smily77/Crawler/crawler/Camera.ino

#ifdef FPV
#include "index_html.h"

static esp_err_t index_handler(httpd_req_t *req){
  httpd_resp_set_type(req, "text/html");
  return httpd_resp_send(req, (const char *)INDEX_HTML, strlen(INDEX_HTML));
}

static esp_err_t stream_handler(httpd_req_t *req){
  camera_fb_t * fb = NULL;
  esp_err_t res = ESP_OK;
  size_t _jpg_buf_len = 0;
  uint8_t * _jpg_buf = NULL;
  char * part_buf[64];

  res = httpd_resp_set_type(req, _STREAM_CONTENT_TYPE);
  if(res != ESP_OK){
    return res;
  }
  streamActive = true;   // pause OTA while streaming

  while(true){
    fb = esp_camera_fb_get();
    if (!fb) {
      Serial.println("Camera capture failed");
      res = ESP_FAIL;
    } else {
      if(fb->width > 400){
        if(fb->format != PIXFORMAT_JPEG){
          bool jpeg_converted = frame2jpg(fb, 80, &_jpg_buf, &_jpg_buf_len);
          esp_camera_fb_return(fb);
          fb = NULL;
          if(!jpeg_converted){
            Serial.println("JPEG compression failed");
            res = ESP_FAIL;
          }
        } else {
          _jpg_buf_len = fb->len;
          _jpg_buf = fb->buf;
        }
      }
    }
    if(res == ESP_OK){
      size_t hlen = snprintf((char *)part_buf, 64, _STREAM_PART, _jpg_buf_len);
      res = httpd_resp_send_chunk(req, (const char *)part_buf, hlen);
    }
    if(res == ESP_OK){
      res = httpd_resp_send_chunk(req, (const char *)_jpg_buf, _jpg_buf_len);
    }
    if(res == ESP_OK){
      res = httpd_resp_send_chunk(req, _STREAM_BOUNDARY, strlen(_STREAM_BOUNDARY));
    }
    if(fb){
      esp_camera_fb_return(fb);
      fb = NULL;
      _jpg_buf = NULL;
    } else if(_jpg_buf){
      free(_jpg_buf);
      _jpg_buf = NULL;
    }
    if(res != ESP_OK){
      break;
    }
    //Serial.printf("MJPG: %uB\n",(uint32_t)(_jpg_buf_len));
  }
  streamActive = false;  // client gone, OTA available again
  return res;
}

static esp_err_t cmd_handler(httpd_req_t *req){
  char*  buf;
  size_t buf_len;
  char variable[32] = {0,};
  char xs[8] = {0,}, ys[8] = {0,}, fs[4] = {0,}, vs[4] = {0,};
  
  buf_len = httpd_req_get_url_query_len(req) + 1;
  if (buf_len > 1) {
    buf = (char*)malloc(buf_len);
    if(!buf){
      httpd_resp_send_500(req);
      return ESP_FAIL;
    }
    if (httpd_req_get_url_query_str(req, buf, buf_len) == ESP_OK) {
      if (httpd_query_key_value(buf, "go", variable, sizeof(variable)) == ESP_OK) {
        // optional parameters for web control: x, y (-512..512), f (fire 0/1), v (light 0/1)
        httpd_query_key_value(buf, "x", xs, sizeof(xs));
        httpd_query_key_value(buf, "y", ys, sizeof(ys));
        httpd_query_key_value(buf, "f", fs, sizeof(fs));
        httpd_query_key_value(buf, "v", vs, sizeof(vs));
      } else {
        free(buf);
        httpd_resp_send_404(req);
        return ESP_FAIL;
      }
    } else {
      free(buf);
      httpd_resp_send_404(req);
      return ESP_FAIL;
    }
    free(buf);
  } else {
    httpd_resp_send_404(req);
    return ESP_FAIL;
  }

  sensor_t * s = esp_camera_sensor_get();
  int res = 0;
  
  if(!strcmp(variable, "forward")) {
    Serial.println("Forward");
    processJoystickInput(0, -webSpeed);
  }
  else if(!strcmp(variable, "left")) {
    Serial.println("Left");
    processJoystickInput(-webSpeed/2,0);
  }
  else if(!strcmp(variable, "right")) {
    Serial.println("Right");
    processJoystickInput(webSpeed
    /2,0);
  }
  else if(!strcmp(variable, "backward")) {
    Serial.println("Backward");
    processJoystickInput(0, webSpeed);
  }
  else if(!strcmp(variable, "xy")) {      // XY pad + fire, sent repeatedly while touched
    webX = constrain(atoi(xs), -512, 512);
    webY = constrain(atoi(ys), -512, 512);
    webFire = (atoi(fs) != 0);
    lastWebCmd = millis();
    webActive = true;
    webNew = true;
  }
  else if(!strcmp(variable, "light")) {   // full front light on/off
    webLightReq = (atoi(vs) != 0) ? 1 : 0;
  }
  else if(!strcmp(variable, "camled")) {  // flash LED on the ESP32-CAM board on/off
    webCamLedReq = (atoi(vs) != 0) ? 1 : 0;
  }
  else if(!strcmp(variable, "stop")) {
    Serial.println("Stop");
    stopMotors();
  }
  else {
    res = -1;
  }

  if(res){
    return httpd_resp_send_500(req);
  }

  httpd_resp_set_hdr(req, "Access-Control-Allow-Origin", "*");
  return httpd_resp_send(req, NULL, 0);
}
#endif
#ifdef FPV
// Apply web commands in loop() context; stop if the page stops sending
void handleWebControl() {
  static bool fireOn = false;
  if (webLightReq >= 0) {
    if (crawlerType == CRAWLER_PCA) setFrontLight(webLightReq ? 65 : 0);
    webLightReq = -1;
  }
  if (webCamLedReq >= 0) {
    digitalWrite(CAM_LED_PIN, webCamLedReq ? HIGH : LOW);
    webCamLedReq = -1;
  }
  if (!webActive) return;
  bool fireWanted = webFire;
  if (millis() - lastWebCmd > WEB_TIMEOUT) {   // page released or connection lost
    webActive = false;
    fireWanted = false;
    stopMotors();
  } else if (webNew) {
    webNew = false;
    processJoystickInput(webX, webY);
  }
  if (fireWanted != fireOn) {
    fireOn = fireWanted;
    if (crawlerType == CRAWLER_PCA) setLed(fireOut, fireOn ? 4095 : 0);
  }
}

void startCameraServer(){
  httpd_config_t config = HTTPD_DEFAULT_CONFIG();
  config.server_port = 80;
  httpd_uri_t index_uri = {
    .uri       = "/",
    .method    = HTTP_GET,
    .handler   = index_handler,
    .user_ctx  = NULL
  };

  httpd_uri_t cmd_uri = {
    .uri       = "/action",
    .method    = HTTP_GET,
    .handler   = cmd_handler,
    .user_ctx  = NULL
  };
  httpd_uri_t stream_uri = {
    .uri       = "/stream",
    .method    = HTTP_GET,
    .handler   = stream_handler,
    .user_ctx  = NULL
  };
  if (httpd_start(&camera_httpd, &config) == ESP_OK) {
    httpd_register_uri_handler(camera_httpd, &index_uri);
    httpd_register_uri_handler(camera_httpd, &cmd_uri);
  }
  config.server_port += 1;
  config.ctrl_port += 1;
  if (httpd_start(&stream_httpd, &config) == ESP_OK) {
    httpd_register_uri_handler(stream_httpd, &stream_uri);
  }
}
#endif
void camSetup() {
#ifdef FPV
  camera_config_t config;
  config.ledc_channel = LEDC_CHANNEL_0;
  config.ledc_timer = LEDC_TIMER_0;
  config.pin_d0 = Y2_GPIO_NUM;
  config.pin_d1 = Y3_GPIO_NUM;
  config.pin_d2 = Y4_GPIO_NUM;
  config.pin_d3 = Y5_GPIO_NUM;
  config.pin_d4 = Y6_GPIO_NUM;
  config.pin_d5 = Y7_GPIO_NUM;
  config.pin_d6 = Y8_GPIO_NUM;
  config.pin_d7 = Y9_GPIO_NUM;
  config.pin_xclk = XCLK_GPIO_NUM;
  config.pin_pclk = PCLK_GPIO_NUM;
  config.pin_vsync = VSYNC_GPIO_NUM;
  config.pin_href = HREF_GPIO_NUM;
  config.pin_sccb_sda = SIOD_GPIO_NUM;
  config.pin_sccb_scl = SIOC_GPIO_NUM;
  config.pin_pwdn = PWDN_GPIO_NUM;
  config.pin_reset = RESET_GPIO_NUM;
  config.xclk_freq_hz = 20000000;
  config.pixel_format = PIXFORMAT_JPEG; 
  
  if(psramFound()){
    Serial << "PSRAM" << endl;
    config.frame_size = FRAMESIZE_VGA;
    config.jpeg_quality = 10;
    config.fb_count = 2;
  } else {
    Serial << "No PSRAM" << endl;
    config.frame_size = FRAMESIZE_SVGA;
    config.jpeg_quality = 12;
    config.fb_count = 1;
  }
  // Camera init
  esp_err_t err = esp_camera_init(&config);
  if (err != ESP_OK) {
    Serial.printf("Camera init failed with error 0x%x", err);
    return;
  }
  sensor_t * s = esp_camera_sensor_get();
  s->set_hmirror(s, 1);        // 0 = disable , 1 = enable
  s->set_vflip(s, 1);          // 0 = disable , 1 = enable
#endif
}
