smily77/Crawler/(commit log)

2026-10-15 Initialer Stand: crawler (aus combi10) und OSC_Joystick (aus OSC_Joystick10)
2026-10-15 Dokumentation: README mit Systembeschreibung, Foto und Schemas
    - README beschreibt beide Crawler (ESP32-CAM, Wemos D1 mini), TouchOSC-
    und Joystick-Steuerung, Protokolle, Fahr-/Lichtlogik, Pinbelegung,
    Kompilieren und bekannte offene Punkte
    - docs/: Foto der Crawler und SVG-Schemas für beide Crawler und den Joystick
2026-10-15 Translate documentation and code comments to English
    - README and schematics rewritten in English
    - Code comments and serial messages translated
    - German identifiers renamed: taster -> enableBtnPin, tasterLed -> enableLedPin,
    isHandy -> isPhone, setLed(kanal, helligkeit) -> setLed(channel, brightness)
    - crawler/Kamera.ino renamed to crawler/Camera.ino
    - No functional changes
2026-10-15 Pause OTA while FPV stream is active; port crawler to ESP32 core 3.x
    - OTA: stream_handler sets streamActive while a client watches the
    stream; loop() only calls ArduinoOTA.handle() when no stream is
    active, so OTA no longer causes stutter and is available otherwise.
    - Core 3.x: new ESP-NOW recv/send callback signatures and
    ledcAttachChannel/ledcWriteChannel (same channels 0-3 as before),
    guarded by version checks so core 2.x still compiles.
    Build: esp32:esp32:esp32cam with PartitionScheme=min_spiffs (OTA).
    [Camera.ino, Init.ino, Motors.ino, autoPairEspNow.ino, crawler.ino]
2026-10-15 Add web controls: XY pad, full light and fire buttons
    - New mobile web page (index_html.h) with FPV stream, XY pad for tank
    steering (like the TouchOSC pad, steering limited to 1/3 like the
    hardware joystick), toggle for full front light and hold-to-fire.
    - /action?go=xy&x=&y=&f= and /action?go=light&v= endpoints; the HTTP
    handler only stores values, loop() applies them so PCA9685 access
    stays in one task.
    - Safety: motors stop and fire turns off if no web command arrives
    for 500 ms (pad released, tab hidden or connection lost).
    - HTML moved to a .h file so the Arduino preprocessor does not parse
    the JavaScript.
2026-10-15 Joystick WiFi/ESP-NOW switch, ESP-NOW buttons, ESP8266 crawler support
    Joystick:
    - WiFi (OSC) if it can connect, otherwise ESP-NOW; touch L+R held for
    ~1 s toggles the mode manually. Optional AUTO_MODE_SWITCH (off by
    default) asks the crawler for its WiFi state and falls back on loss.
    - Non-blocking channel scan in ESP-NOW mode, re-pairing after failed
    sends, neutral OSC packet before leaving WiFi mode.
    - Fire (button1) and full light (button2) sent via ESP-NOW, steering
    limited to 1/3 like OSC, sends to the paired MAC.
    - OTA (hostname ESP-Joystick), ESP32 core 3.x callbacks, GPIO36
    without internal pull-up.
    Crawler:
    - ESP-NOW message size collision fixed (pairing and joystick mes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
    [BroadCast.ino, Init.ino, OSC.ino, OSC_Joystick.ino, autoPairEspNow.ino, crawler.ino]
2026-10-15 Crawler: wait up to 20 s for WiFi and stop auto-reconnect when giving up
    After an OTA reboot the WiFi connection sometimes took longer than
    10 s. The crawler then switched to ESP-NOW-only mode, but the core's
    auto-reconnect still connected later via DHCP (192.168.0.68) instead
    of the static IP, so OSC commands no longer reached it.
    [Init.ino]
2026-10-18 Crawler: connect to the strongest AP when several share the SSID
    The ESP32 used the default fast scan and joined the first AP found,
    even when another AP with the same SSID was right next to it. It now
    scans all channels and sorts by signal strength. The ESP8266 scans
    manually and connects to the BSSID with the best RSSI. The chosen AP
    and its RSSI are printed on the serial console.
2026-10-18 Crawler: roam to a stronger AP while driving
    When the RSSI drops below -70 dBm, the crawler runs a background scan
    (at most every 15 s) and switches to an AP with the same SSID that is
    at least 8 dB stronger, keeping the static IP. If the chosen AP cannot
    be reached within 10 s, it falls back to connecting to any AP.
    The joystick re-pairs on its own if the new AP uses another channel.
2026-10-18 Crawler: roam without interrupting the camera stream
    The roaming scan hopped through all channels every 15 s whenever the
    RSSI was below -70 dBm, which froze the FPV stream for seconds. It now
    scans only the current channel (below -72 dBm, at most every 20 s) and
    scans all channels only below -82 dBm, at most once a minute.
    At startup a short scan for our SSID replaces the slow all-channel
    connect scan; begin() with BSSID and channel then connects directly.
    [Init.ino, Roaming.ino]
2026-11-08 Crawler: web button for the ESP32-CAM flash LED
    Adds a "Cam LED" toggle to the web page that switches the on-board
    flash LED (GPIO 4) via /action?go=camled&v=0|1. The LED stays off at
    boot as before.
